acastles91/soundwalk/hw/Soundwalk/Mouser_BOM.xls

SHOPPING BASKET
This is not an invoice
14-Aug-25 05:26:35
 | Mouser No | Mfr. No | Manufacturer | Customer No | Description | RoHS | Lifecycle | Order Qty. | Price (EUR) | Ext.: (EUR)
1 | 603-RC0603FR-075K1L | RC0603FR-075K1L | YAGEO |  | Thick Film Resistors - SMD General Purpose Chip Resistor 0603, 5.1kOhms, 1%, 1/10W | RoHS Compliant By Exemption |  | 100 | 0,006 € | 0,60 €
2 | 963-EMK105B7104KV-F | EMK105B7104KV-F | TAIYO YUDEN |  | Multilayer Ceramic Capacitors MLCC - SMD/SMT 963-MSASE105SB7104KF RPLCMT PN 16V 0.1uF X7R 0402 10% | RoHS Compliant |  | 50 | 0,019 € | 0,95 €
3 | 187-CL05B104KP5VPNC | CL05B104KP5VPNC | Samsung Electro-Mechanics |  | Multilayer Ceramic Capacitors MLCC - SMD/SMT 0402 X7R 100000pF 10% 10V automotive grade | RoHS Compliant | New Product | 50 | 0,022 € | 1,10 €
4 | 279-CRGP2010F27R | CRGP2010F27R | TE Connectivity |  | Thick Film Resistors - SMD CRGP 2010 27R 1% SMD Resistor | RoHS Compliant By Exemption |  | 50 | 0,123 € | 6,15 €
5 | 708-RMCF1206FT33K2 | RMCF1206FT33K2 | SEI Stackpole |  | Thick Film Resistors - SMD 33.2KOhms 1206 0.25W 1% Std Power AEC-Q200 | RoHS Compliant By Exemption |  | 50 | 0,025 € | 1,25 €
6 | 667-ERJ-2RKF4022X | ERJ-2RKF4022X | Panasonic |  | Thick Film Resistors - SMD 0402 40.2Kohms 1% AEC-Q200 | RoHS Compliant By Exemption |  | 50 | 0,022 € | 1,10 €
7 | 660-RK73H1ETTP2103F | RK73H1ETTP2103F | KOA Speer |  | Thick Film Resistors - SMD 0.1watt 210Kohms 1% | RoHS Compliant By Exemption |  | 100 | 0,013 € | 1,30 €
8 | 80-T491C106M25AT7280 | T491C106M025AT7280 | KEMET |  | Tantalum Capacitors - Solid SMD 25V 10uF 2312 20% ESR=1.5ohms | RoHS Compliant |  | 20 | 0,401 € | 8,02 €
9 | 187-CL32B106KBJNNWE | CL32B106KBJNNWE | Samsung Electro-Mechanics |  | Multilayer Ceramic Capacitors MLCC - SMD/SMT 10uF+/-10% 50V X7R 3 1210 | RoHS Compliant |  | 50 | 0,188 € | 9,40 €
10 | 80-C0402C151K5R | C0402C151K5RACTU | KEMET |  | Multilayer Ceramic Capacitors MLCC - SMD/SMT 50V 150pF X7R 0402 10% | RoHS Compliant |  | 50 | 0,036 € | 1,80 €
11 | 708-RMCF0805FT17K4 | RMCF0805FT17K4 | SEI Stackpole |  | Thick Film Resistors - SMD 17.4KOhms 0805 0.125W 1% Std Power AEC-Q200 | RoHS Compliant By Exemption |  | 50 | 0,022 € | 1,10 €
12 | 603-RC0603JR-07200KL | RC0603JR-07200KL | YAGEO |  | Thick Film Resistors - SMD General Purpose Chip Resistor 0603, 200kOhms, 5%, 1/10W | RoHS Compliant By Exemption |  | 50 | 0,003 € | 0,15 €
13 | 581-TAJA475K016R | TAJA475K016RNJ | KYOCERA AVX |  | Tantalum Capacitors - Solid SMD 16V 4.7uF 10% 1206 E SR= 4 Ohm | RoHS Compliant |  | 20 | 0,128 € | 2,56 €
14 | 80-A768EB107M1ELAS36 | A768EB107M1ELAS036 | KEMET |  | Aluminium Organic Polymer Capacitors 25Vol 100uF SMD 2KHr ESR=36 mOhms AECQ200 | RoHS Compliant |  | 25 | 0,209 € | 5,23 €
15 | 621-B340A-F | B340A-13-F | Diodes Incorporated |  | Schottky Diodes & Rectifiers 40V 3A | RoHS Compliant By Exemption |  | 25 | 0,276 € | 6,90 €
16 | 942-IR2136SPBF | IR2136SPBF | Infineon |  | Gate Drivers 3 PHASE DRVR HI & LO SIDE INPUTS | RoHS Compliant | NRND | 3 | 5,93 € | 17,79 €
17 | 875-HZ0805E601R-10 | HZ0805E601R-10 | Laird Technologies |  | Ferrite Beads 600ohms 100MHz .5A Monolithic 0805 SMD | RoHS Compliant |  | 50 | 0,038 € | 1,90 €
18 | 604-APT3216SURCK | APT3216SURCK | Kingbright |  | Single Colour LEDs RED WATER CLEAR | RoHS Compliant |  | 20 | 0,121 € | 2,42 €
19 | 511-LM393D | LM393D | STMicroelectronics |  | Analog Comparators Lo-Pwr Dual Voltage | RoHS Compliant |  | 15 | 2,01 € | 30,15 €
20 | 863-NCP1117LPST33T3G | NCP1117LPST33T3G | onsemi |  | LDO Voltage Regulators LOW DROPOUT REGULATORS | RoHS Compliant |  | 20 | 0,219 € | 4,38 €
21 | 490-PJ-002B | PJ-002B | Same Sky |  | DC Power Connectors Power Jacks | RoHS Compliant |  | 5 | 0,413 € | 2,07 €
22 | 611-PTS526SM15SMTR2L | PTS526SM15SMTR2 LFS | C&K Switches |  | Tactile Switches 50mA 12VDC, 5.2x5.2mm, 1.5mm H, 160gf, G leads, No ground pin, metal actuator | RoHS Compliant |  | 20 | 0,108 € | 2,16 €
23 | 833-MMSS8050-H-TP | MMSS8050-H-TP | Micro Commercial Components (MCC) |  | Bipolar Transistors - BJT 625mW, 25V, 1500mA | RoHS Compliant |  | 20 | 0,071 € | 1,42 €
24 | 652-SRF3216A-222Y | SRF3216A-222Y | Bourns |  | Common Mode Chokes / Filters 2200uH 25% | RoHS Compliant |  | 10 | 0,398 € | 3,98 €
25 | 511-USBLC6-2SC6 | USBLC6-2SC6 | STMicroelectronics |  | ESD Protection Diodes / TVS Diodes ESD Protection Low Cap | RoHS Compliant |  | 20 | 0,209 € | 4,18 €
26 | 661-HHXA500A101MJA0G | HHXA500ARA101MJA0G | Chemi-Con |  | Aluminium Organic Polymer Capacitors 100uF 50V 20% Hybrid Polymer | RoHS Compliant |  | 10 | 1,56 € | 15,60 €
27 | 844-IRLZ44SPBF | IRLZ44SPBF | Vishay |  | MOSFETs TO263 N-CH 60V 50A | RoHS Compliant By Exemption |  | 20 | 1,48 € | 29,60 €
28 | 710-744771115 | 744771115 | Wurth Elektronik |  | Power Inductors - SMD WE-PD 15uH 3.75A DCR=30mOhms AEC-Q200 | RoHS Compliant |  | 10 | 1,69 € | 16,90 €
29 | 80-C0603H470J5GACTU | C0603H470J5GACTU | KEMET |  | Multilayer Ceramic Capacitors MLCC - SMD/SMT | RoHS Compliant | New At Mouser | 20 | 0,399 € | 7,98 €
30 | 637-US1J | US1J | Diotec Semiconductor |  | Rectifiers Ultrafast, SMA, 600V, 1A, 150C | RoHS Compliant By Exemption |  | 20 | 0,163 € | 3,26 €
By submitting your order you agree to these terms and conditions. (https://www.mouser.de/saleterms) |  |  |  |  |  |  |  |  | Merchandise: | 191,40 €
Prices are reflected at the date and time shown. |  |  |  |  |  |  |  |  | Delivery Charge: | 0,00 €
