acastles91/soundwalk/hw/Soundwalk/Soundwalk_BOM.xlsx

Reference | Value | Datasheet | Footprint | Qty | DNP | Digi-Key_PN | Digikey_PN | Digikey_Pn | MPN | Manufacturer_PN
R18,R19 | 0R | ~ | Resistor_SMD:R_1206_3216Metric_Pad1.30x1.75mm_HandSolder | 2 |  |  |  |  | RC0603FR-075K1L
C12,C13 | 47pF | ~ | Capacitor_SMD:C_0603_1608Metric_Pad1.08x0.95mm_HandSolder | 2 |  |  | 712-QSCP251Q470J1GV001TTR-ND |  | QSCP251Q470J1GV001T
C8,C9,C35 | 0.1uF | ~ | Capacitor_SMD:C_1206_3216Metric_Pad1.33x1.80mm_HandSolder | 3
C2 | 100n | https://search.murata.co.jp/Ceramy/image/img/A01X/G101/ENG/GRM155R71C104KA88-01.pdf | Capacitor_SMD:C_0402_1005Metric | 1 |  |  |  |  | EMK105B7104KV-F
C30 | 100nF | ~ | Capacitor_SMD:C_0402_1005Metric | 1 |  |  | 1276-CL05B104KP5VPNCTR-ND |  | CL05B104KP5VPNC
C5,C6 | 1uF | ~ | Capacitor_SMD:C_0805_2012Metric | 2
C3,C36,C37,C38 | 10uF | ~ | Capacitor_SMD:C_1210_3225Metric_Pad1.33x2.70mm_HandSolder | 4
C22,C24,C26%$%x | 10uF | ~ | Capacitor_SMD:CP_Elec_5x5.7 | 3 | DNP
L2 | 15uH | ~ | Inductor_SMD:L_TDK_SLF12565 | 1 |  |  | 445-3842-2-ND |  | SLF12565T-150M4R2-H
C4 | 22uF | ~ | Capacitor_SMD:C_1210_3225Metric_Pad1.33x2.70mm_HandSolder | 1
R12,R13 | 27R | ~ | Resistor_SMD:R_2010_5025Metric_Pad1.40x2.65mm_HandSolder | 2 |  |  |  |  | CRGP2010F27R
R54,R55,R56 | 100R | ~ | Resistor_SMD:R_1206_3216Metric_Pad1.30x1.75mm_HandSolder | 3
R10,R11 | 220R | ~ | Resistor_SMD:R_1206_3216Metric_Pad1.30x1.75mm_HandSolder | 2
R14,R15,R16,R17,R45,R51,R53,R57,R58,R66 | 1K | ~ | Resistor_SMD:R_1206_3216Metric_Pad1.30x1.75mm_HandSolder | 10 |  |  |  |  | -- mixed values --
R1,R2,R29,R39,R49 | 5.1k | ~ | Resistor_SMD:R_0603_1608Metric | 5 |  |  |  |  | RC0603FR-075K1L
R3,R4,R5,R6,R7,R8,R9,R20,R21,R22,R23,R24,R26,R27,R28,R30,R31,R32,R33,R34,R35,R36,R38,R40,R41,R42,R43,R44,R48,R50,R65 | 10K | ~ | Resistor_SMD:R_0603_1608Metric_Pad0.98x0.95mm_HandSolder | 31
R25,R37,R46 | 33K | ~ | Resistor_SMD:R_1206_3216Metric_Pad1.30x1.75mm_HandSolder | 3 |  |  | RMCF1206FT33K2TR-ND |  | RMCF1206FT33K2
R63 | 40.2k | ~ | Capacitor_SMD:C_0402_1005Metric_Pad0.74x0.62mm_HandSolder | 1 |  |  | P40.2KLTR-ND |  | ERJ-2RKF4022X
R47 | 100K | ~ | Resistor_SMD:R_1206_3216Metric_Pad1.30x1.75mm_HandSolder | 1
R64 | 210k | ~ | Capacitor_SMD:C_0402_1005Metric_Pad0.74x0.62mm_HandSolder | 1 |  |  | 2019-RK73H1ETTP2103FTR-ND |  | RK73H1ETTP2103F
R52 | 1M | ~ | Resistor_SMD:R_1206_3216Metric_Pad1.30x1.75mm_HandSolder | 1
U1 | 2137160001-Molex-USB-C-Connector | https://www.molex.com/en-us/products/part-detail-pdf/2137160001?display=pdf | privateParts:MOLEX_2137160001 | 1
C1,C11,C15,C16,C17,C19 | 0.1uF X7R 50V 0805 | ~ | Capacitor_SMD:C_0805_2012Metric_Pad1.18x1.45mm_HandSolder | 6
R60,R62 | 100K 1206 | ~ | Resistor_SMD:R_1206_3216Metric | 2
C7,C10 | 10uF 25V 2312 Tantalum | ~ | Capacitor_Tantalum_SMD:CP_EIA-6032-15_Kemet-U | 2 |  |  | 399-10160-2-ND |  | T491C106M025AT7280
C18,C23,C25,C27 | 10uF 50V X7R | ~ | -- mixed values -- | 4 |  | -- mixed values -- |  |  |  | -- mixed values --
C28 | 10uF 50V X7R 1210 | ~ | Capacitor_SMD:C_1210_3225Metric | 1 |  |  | 1276-3388-2-ND |  | CL32B106KBJNNWE
C31 | 150pF 0805 | ~ | Capacitor_SMD:C_0805_2012Metric | 1 |  |  | 399-C0402C151K5RACTUTR-ND |  | C0402C151K5RACTU
R59 | 17.4K 0805 | ~ | Resistor_SMD:R_0805_2012Metric | 1 |  |  | RMCF0805FT17K4TR-ND |  | RMCF0805FT17K4
R61 | 200K 0603 | ~ | Resistor_SMD:R_0603_1608Metric | 1 |  |  | 311-200KGRTR-ND |  | RC0603JR-07200KL
C29,C32,C33 | 22uF 6.3V | ~ | Capacitor_SMD:C_1206_3216Metric_Pad1.33x1.80mm_HandSolder | 3 |  |  | 478-12066C226MAT2A\2.5KTR-ND |  | 12066C226MAT2A\2.5K
Q3,Q4,Q5,Q6,Q7,Q8,Q9 | 2N7002E | http://www.diodes.com/assets/Datasheets/ds30376.pdf | Package_TO_SOT_SMD:SOT-23 | 7
C20 | 330uF 35V |  | Capacitor_SMD:CP_Elec_10x10.5 | 1 | DNP | 565-4786-1-ND |  |  | HHXC500ARA101MJA0G
C21 | 330uF 35V |  | Capacitor_SMD:CP_Elec_10x10.5 | 1 |  | 565-4786-1-ND |  |  | HHXC500ARA101MJA0G
C14 | 4.7uF 16V 1206 Tantalum | ~ | Capacitor_SMD:C_1206_3216Metric_Pad1.33x1.80mm_HandSolder | 1 |  |  | 478-3868-2-ND |  | TAJA475K016RNJ
C34 | C_Polarized | ~ | Capacitor_SMD:CP_Elec_6.3x5.9 | 1 |  |  | 399-A768EB107M1ELAS036TR-ND |  | A768EB107M1ELAS036
J5 | Conn_01x04_Socket | ~ | Connector_PinHeader_2.54mm:PinHeader_1x04_P2.54mm_Vertical | 1
J1 | Conn_02x06_Odd_Even | ~ | Connector_PinHeader_2.54mm:PinHeader_2x06_P2.54mm_Vertical | 1
D10 | D_Schottky | ~ | Diode_SMD:D_SMA_Handsoldering | 1 |  |  | B340A-FDITR-ND |  | B340A-13-F
U12 | DRV8833PWP | http://www.ti.com/lit/ds/symlink/drv8833.pdf | Package_SO:HTSSOP-16-1EP_4.4x5mm_P0.65mm_EP3.4x5mm_Mask2.46x2.31mm_ThermalVias | 1
U2 | ESP32-WROOM-E | https://www.espressif.com/sites/default/files/documentation/esp32-wroom-32e_esp32-wroom-32ue_datasheet_en.pdf | RF_Module:ESP32-WROOM-32E | 1
U6 | FT231XS | https://www.ftdichip.com/Support/Documents/DataSheets/ICs/DS_FT231X.pdf | Package_SO:SSOP-20_3.9x8.7mm_P0.635mm | 1 |  |  | 768-1156-5-ND |  | FT231XS-U
U9 | IR2136 |  | Package_SO:SOIC-28W_7.5x18.7mm_P1.27mm | 1 |  | IR2136SPBF-ND |  |  | IR2136SPBF
Q10,Q11,Q12,Q13,Q14,Q15,Q16 | IRLZ44N | http://www.irf.com/product-info/datasheets/data/irlz44n.pdf | Package_TO_SOT_SMD:TO-263-2 | 7 |  |  | IRLZ44NSTRLPBFTR-ND |  | IRLZ44NSTRLPBF
JP1,JP2,JP3,JP4,JP5,JP6,JP7,JP8 | Jumper_2_Open | ~ | Connector_PinHeader_2.54mm:PinHeader_1x02_P2.54mm_Vertical | 8
L1 | L_Ferrite | ~ | Inductor_SMD:L_0805_2012Metric_Pad1.05x1.20mm_HandSolder | 1 |  |  | 240-2399-2-ND |  | HZ0805E601R-10
D3,D6 | LED - Red | ~ | LED_SMD:LED_1206_3216Metric_Pad1.42x1.75mm_HandSolder | 2 |  |  | 754-1143-2-ND |  | APT3216SURCK
D2,D4,D5 | LED - Yellow | ~ | LED_SMD:LED_1206_3216Metric_Pad1.42x1.75mm_HandSolder | 3
U7,U8 | LM393 | http://www.ti.com/lit/ds/symlink/lm393.pdf | Package_SO:SOP-8_3.9x4.9mm_P1.27mm | 2 |  |  |  | 497-18379-ND | LM393D
U5 | NCP1117-3.3_SOT223 | http://www.onsemi.com/pub_link/Collateral/NCP1117-D.PDF | Package_TO_SOT_SMD:SOT-223-3_TabPin2 | 1 |  |  | NCP1117LPST33T3GOSTR-ND |  | NCP1117LPST33T3G
U10 | OKI-78SR-5_1.5-W36H-C | https://power.murata.com/data/power/oki-78sr.pdf | Converter_DCDC:Converter_DCDC_Murata_OKI-78SR_Horizontal | 1
J3 | PJ-002B |  | privateParts:CUI_PJ-002B | 1 |  |  | CP-002B-ND |  | PJ-002B
SW1,SW2 | PTS526 SM15 SMTR2 LFS | PTS526 SM15 SMTR2 LFS | SON4_PTS526 SM15 SMTR2 LFS_CNK | 2 |  |  | CKN12220-2-ND |  | PTS526SM15SMTR2 LFS
Q1,Q2 | S8050 | https://www.mccsemi.com/pdf/Products/MMSS8050(SOT-23).pdf | Package_TO_SOT_SMD:SOT-23 | 2 |  |  | MMSS8050-H-TPMSCT-ND |  | MMSS8050-H-TP
J4,J6 | Screw_Terminal_01x02 | ~ | Connector_JST:JST_XH_B2B-XH-A_1x02_P2.50mm_Vertical | 2
J2 | Screw_Terminal_01x03 | ~ | TerminalBlock_WAGO:TerminalBlock_WAGO_236-403_1x03_P5.00mm_45Degree | 1
U4 | SRF3216A-Common_Mode_Choke |  | privateParts:Bourns_SRF3216A | 1 |  | SRF3216A-222YCT-ND |  |  | SRF3216A-222Y
D1 | SS14 | https://www.vishay.com/docs/88746/ss12.pdf | Diode_SMD:D_SMA | 1
D7,D8,D9 | US1J | https://www.diodes.com/assets/Datasheets/ds16008.pdf | Diode_SMD:D_SMA | 3 |  |  | 4878-US1JTR-ND |  | US1J
U3 | %%$ | https://www.st.com/resource/en/datasheet/usblc6-2.pdf | Package_TO_SOT_SMD:SOT-23-6 | 1 |  | 497-5235-1-ND |  |  | USBLC6-2SC6
U11 | ~ |  | Package_SO:SOIC-8-1EP_3.9x4.9mm_P1.27mm_EP2.29x3mm | 1 |  |  | 1589-1587-2-ND |  | MP2467DN-LF-Z
