acastles91/soundwalk/hw/Soundwalk/Soundwalk.pdf

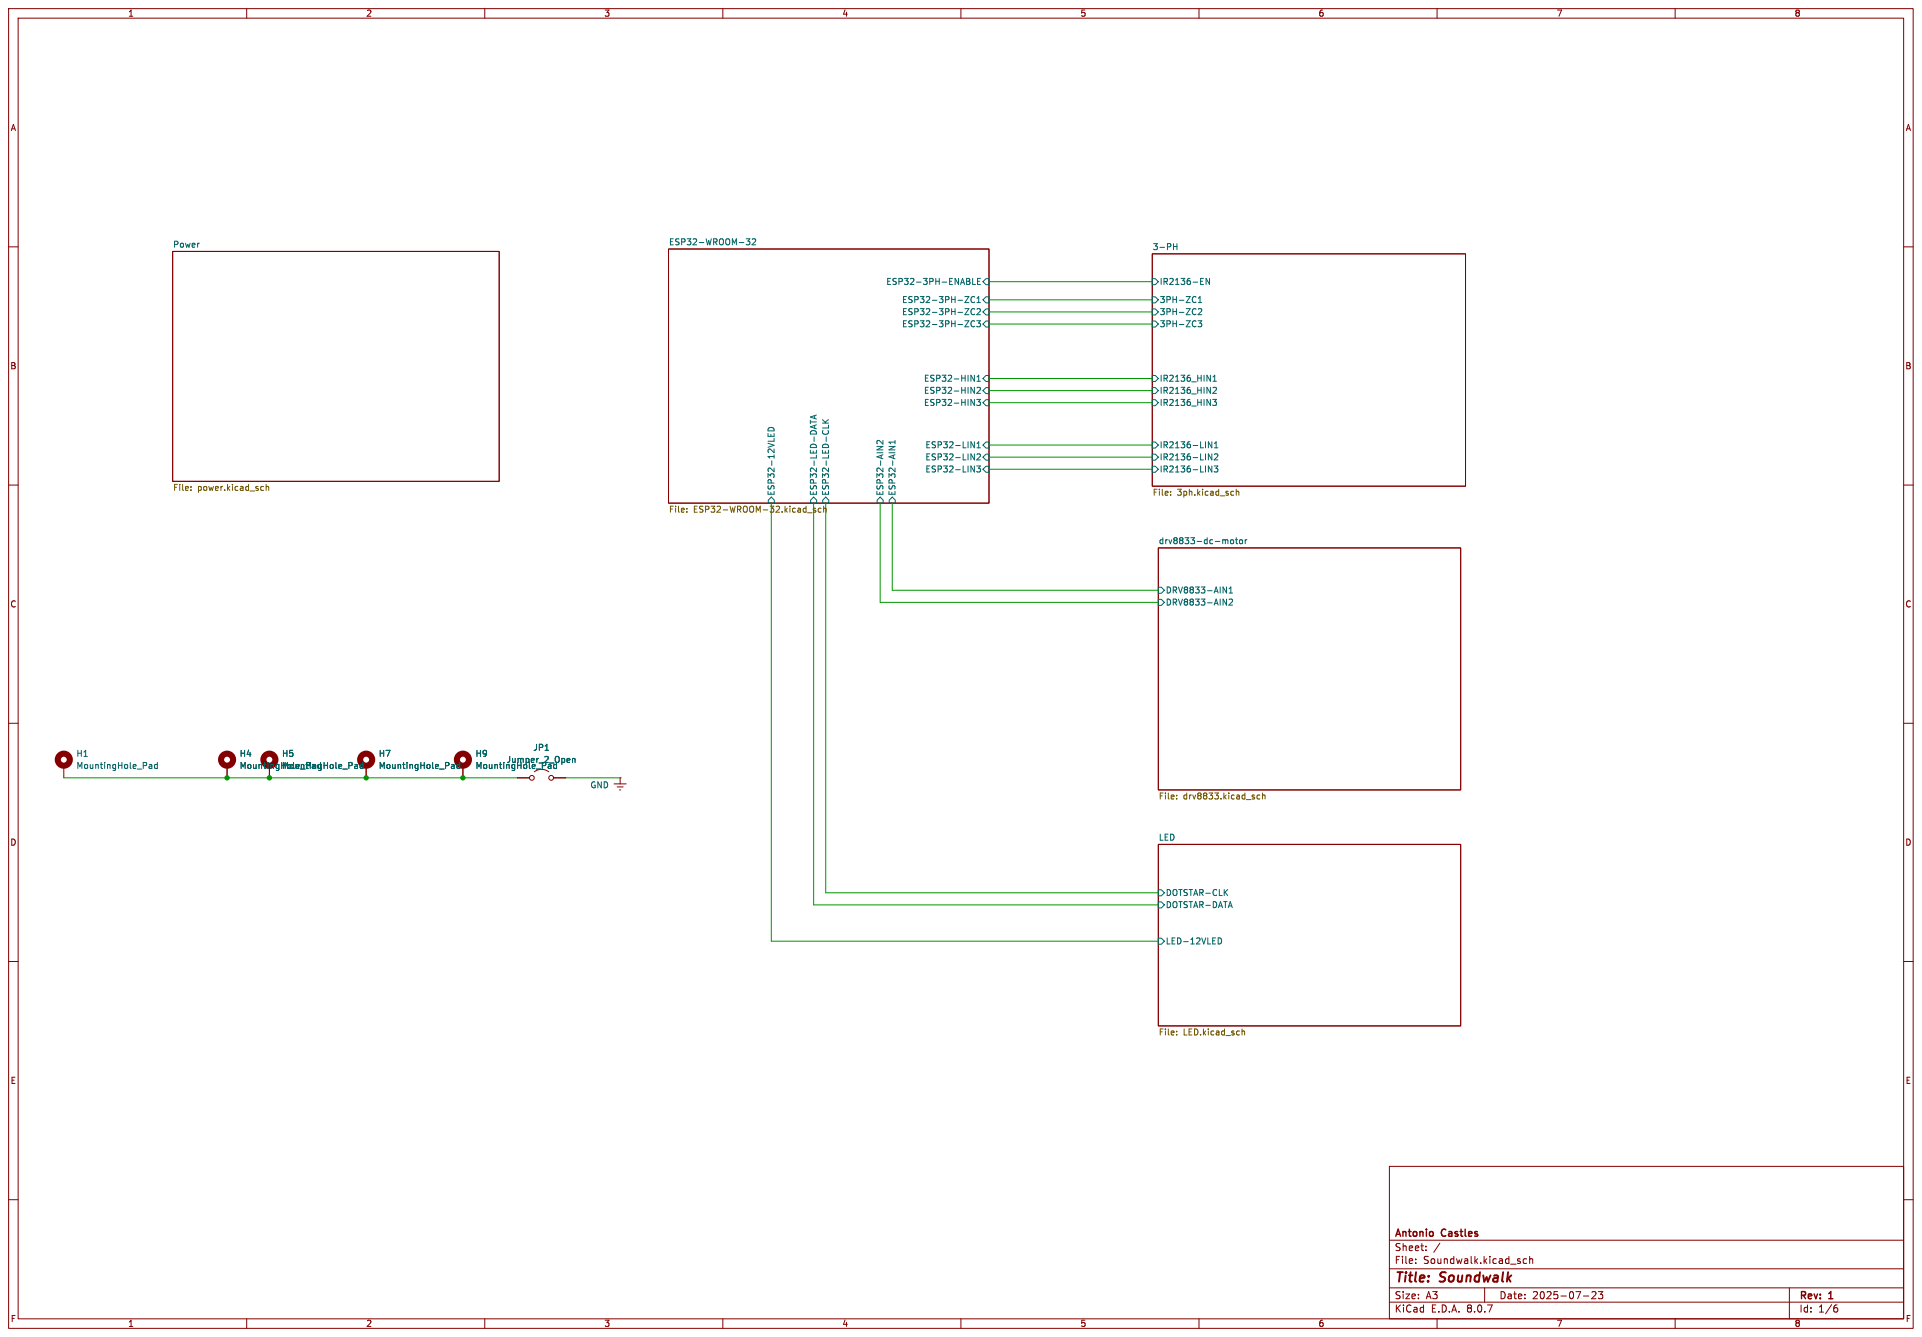
[picture p1: page 1]

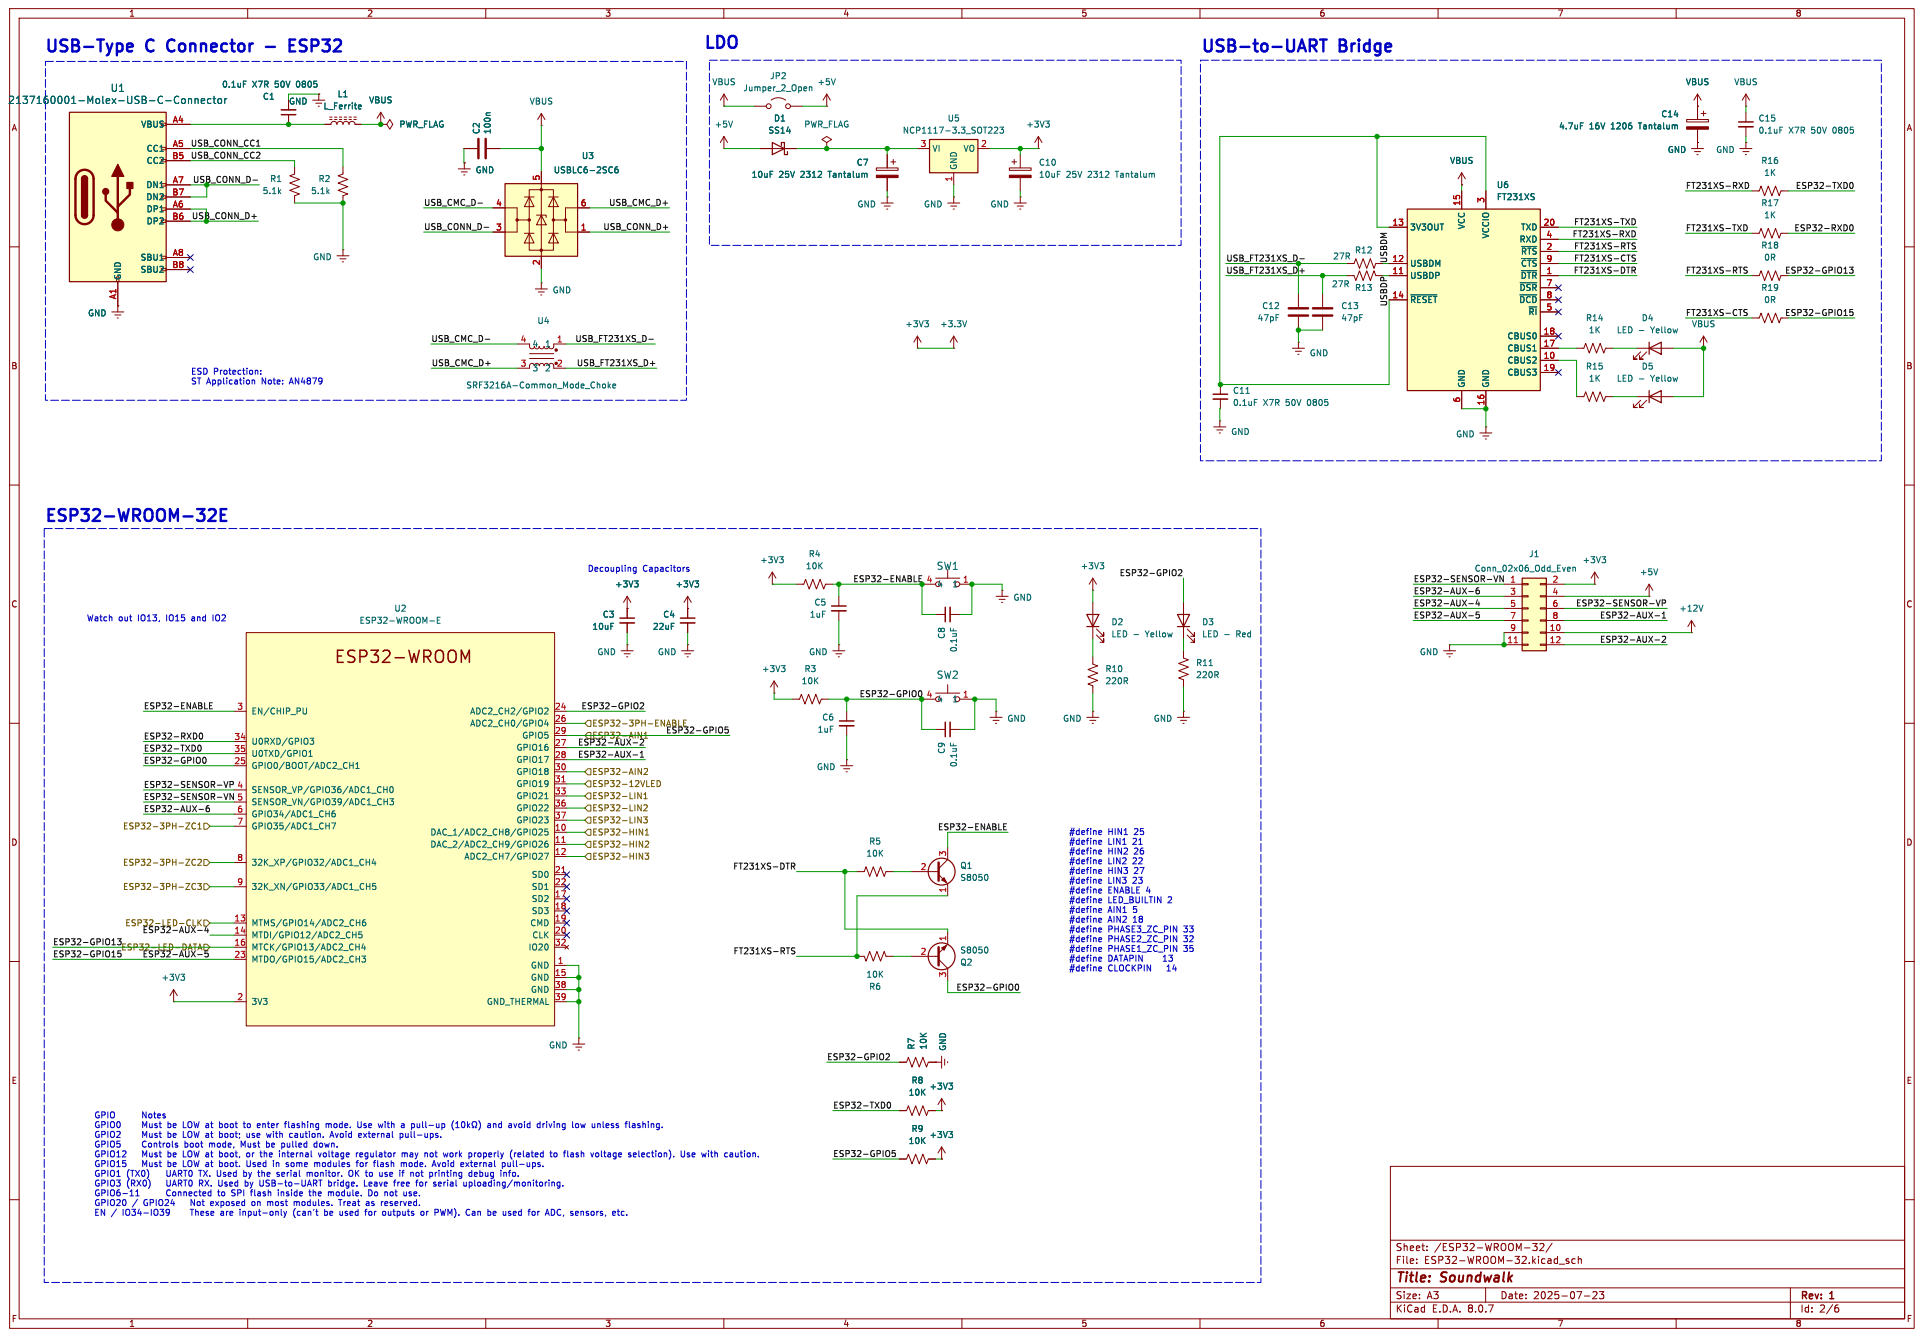
[picture p2: page 2]

1 VO 2 VI 3 U5 NCP1117-3.3_SOT223 GND GND

6 ~{DSR}7 ~{DCD}8 ~{CTS}9 U6 FT231XS GND
VBUS
ESP32-SENSOR-VN USBDM

6 ~{DSR}7 ~{DCD}8 ~{CTS}9 GND

Watch out IO13, IO15 and IO2 ESP32-WROOM-32E

File: ESP32-WROOM-32.kicad_sch Sheet: /ESP32-WROOM-32/

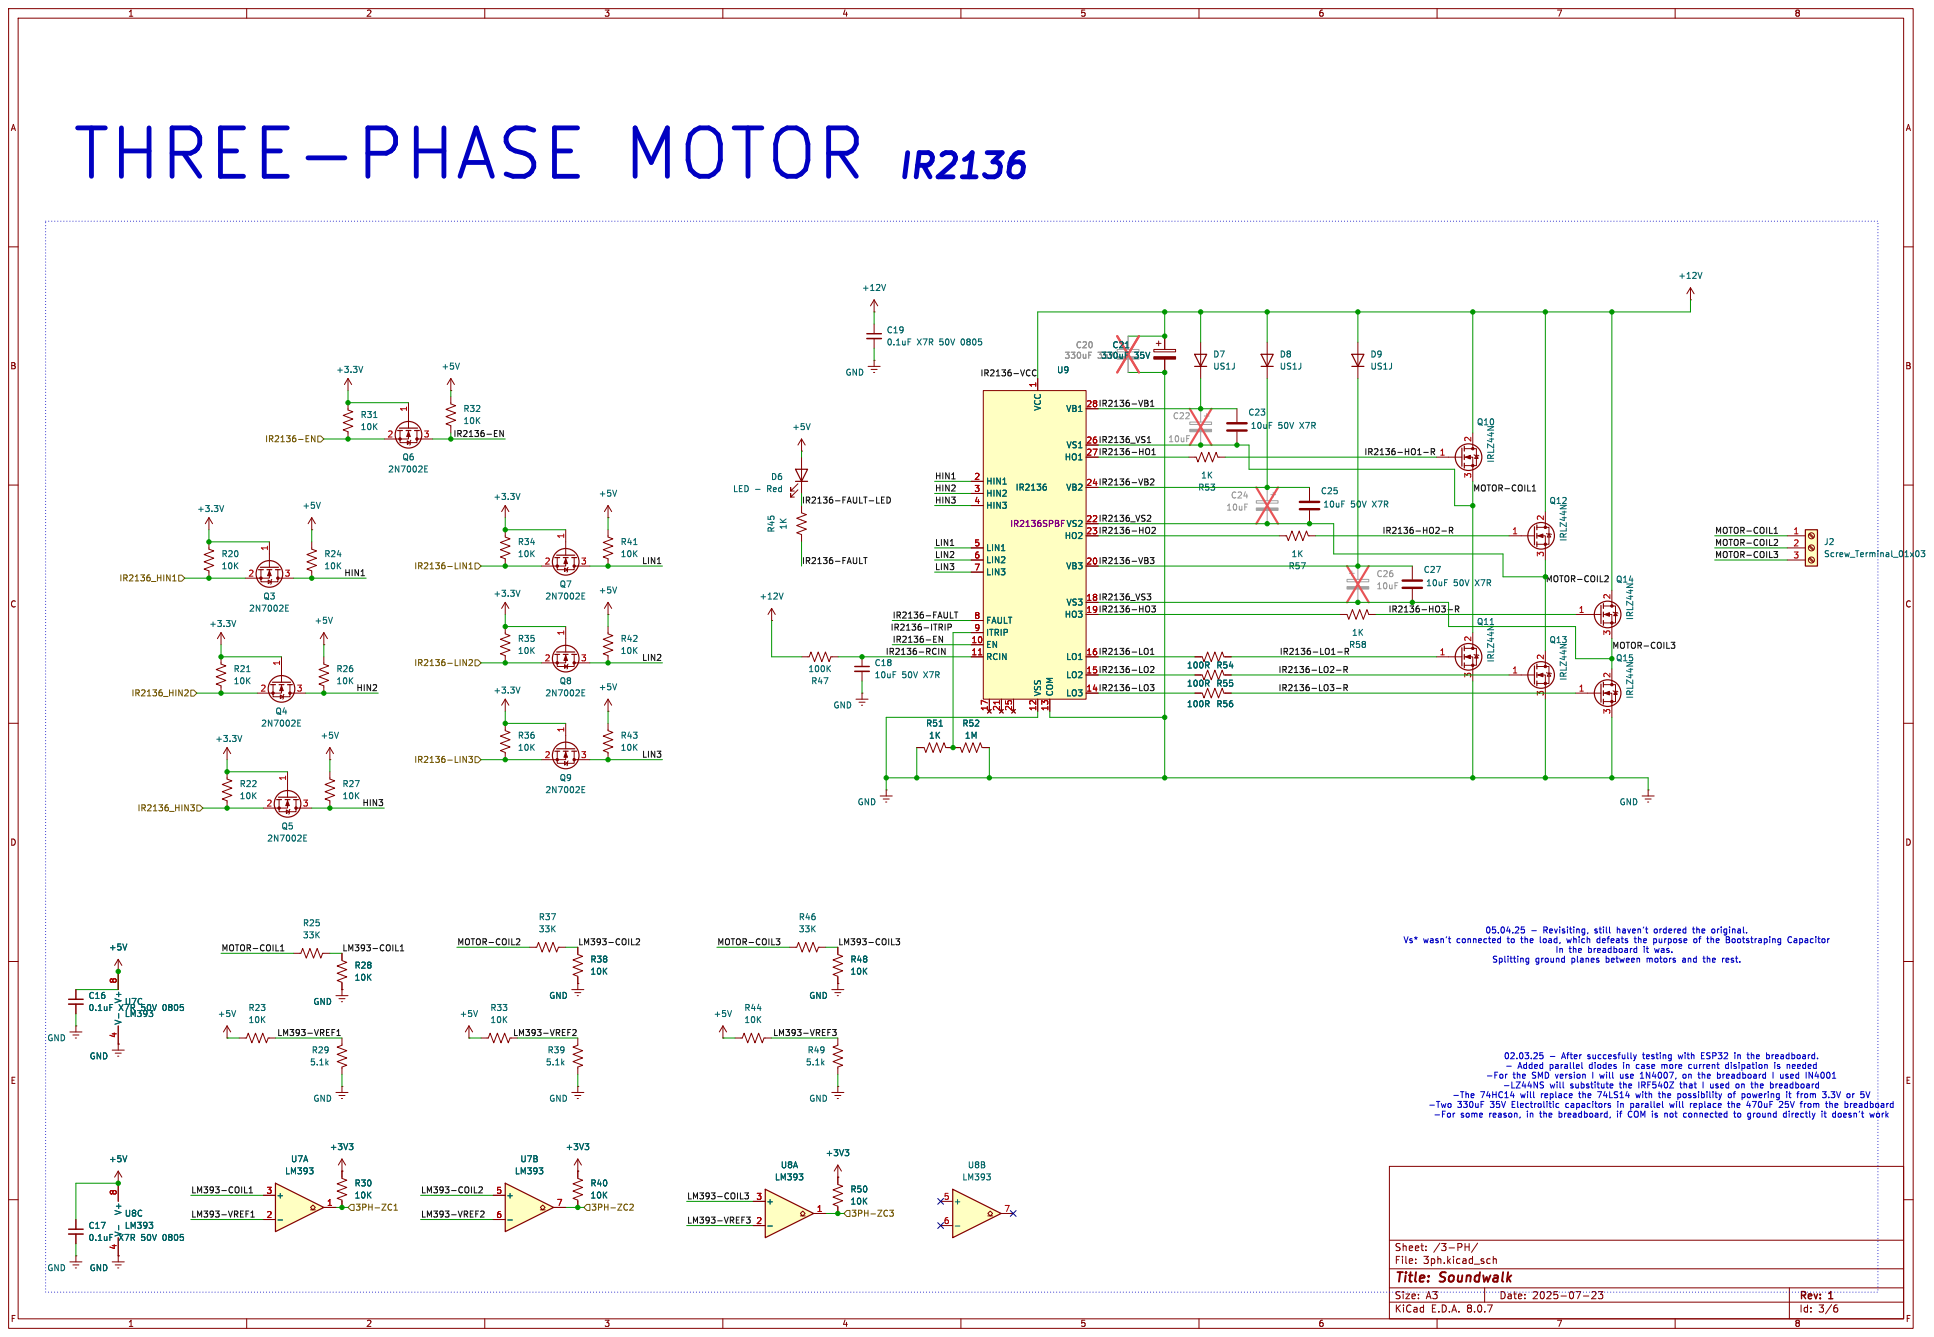
[picture p3: page 3]

1 EN 10 RCIN 11 VSS 12 COM 13

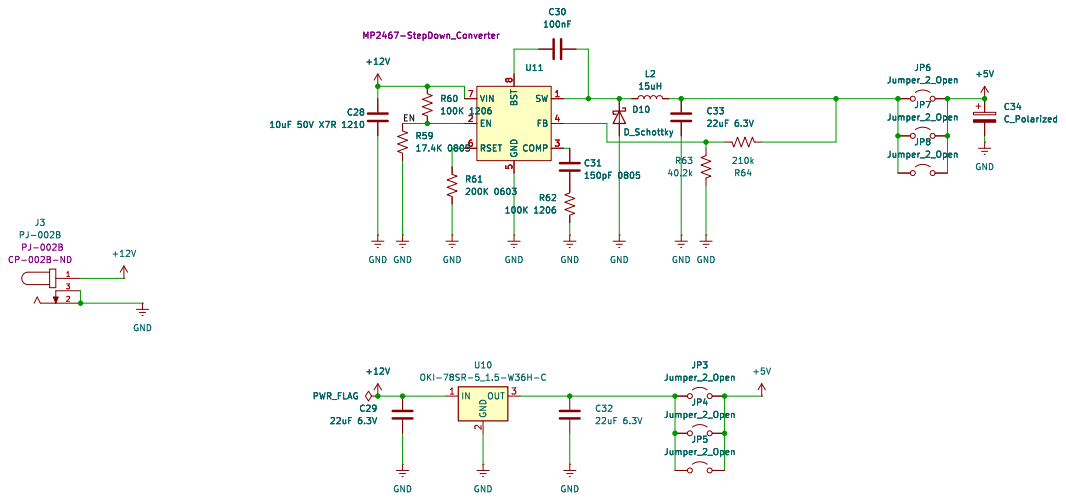
[picture p4: page 4]

2 OUT 3 U10 OKI-78SR-5_1.5-W36H-C GND GND

File: power.kicad_sch Sheet: /Power/

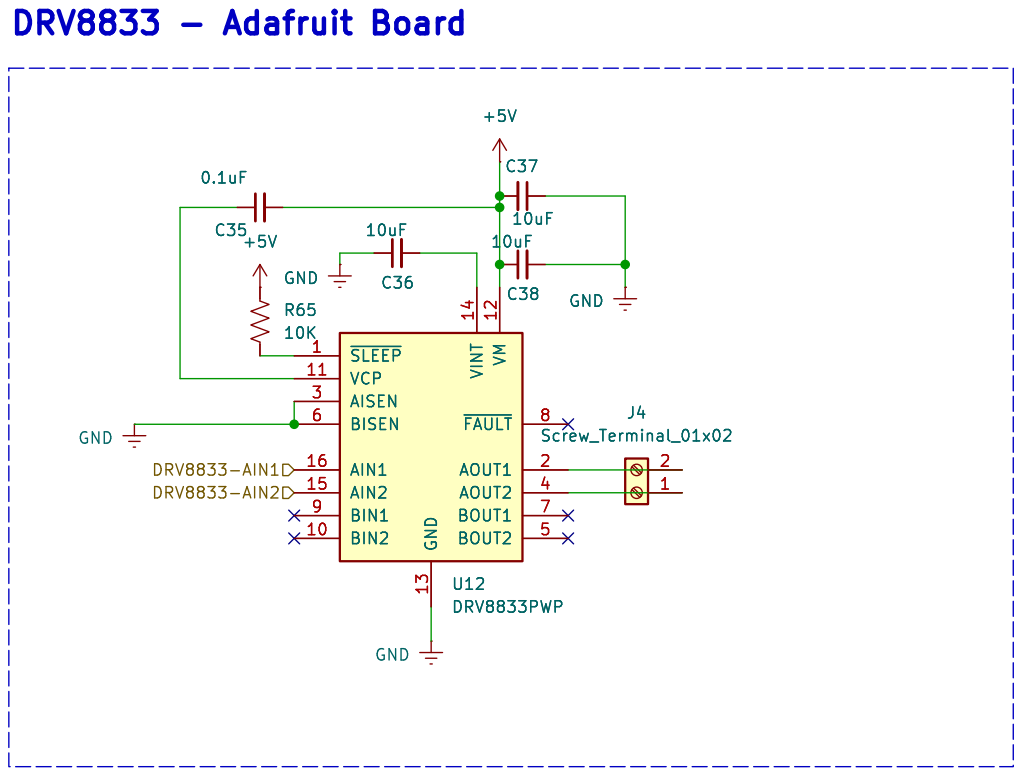
[picture p5: page 5]

File: drv8833.kicad_sch Sheet: /drv8833-dc-motor/

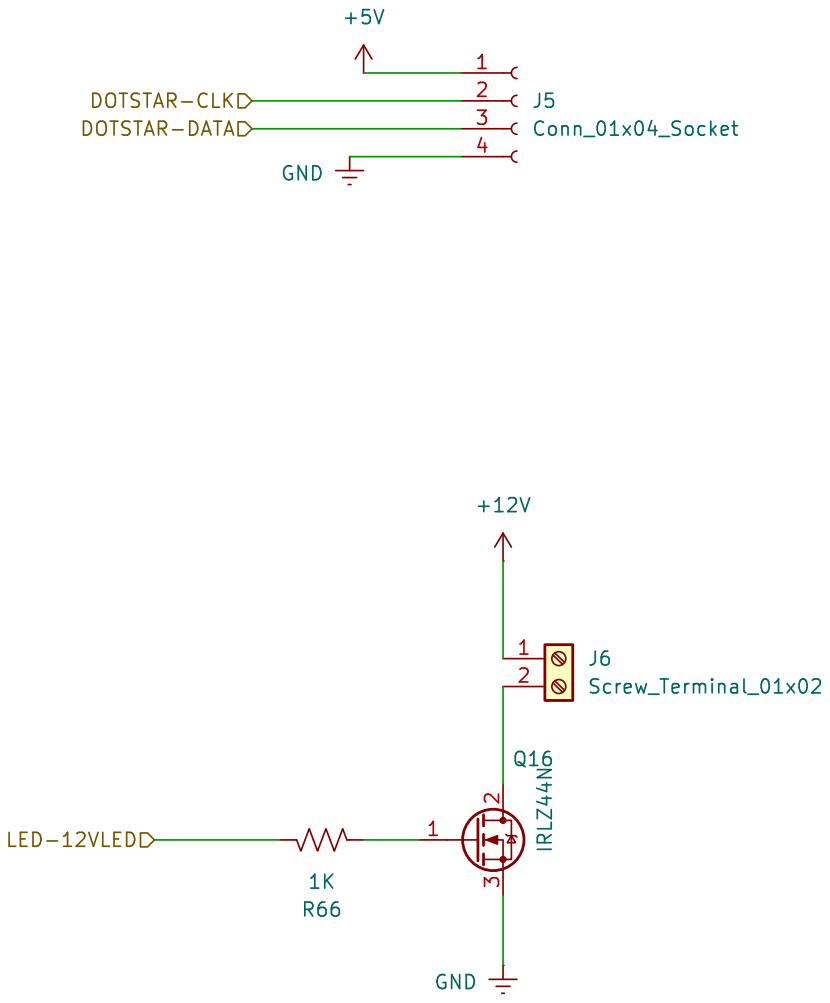
[picture p6: page 6]

J6Screw_Terminal_01x02 +12V DOTSTAR-DATA DOTSTAR-CLK

File: LED.kicad_sch Sheet: /LED/
