acastles91/soundwalk/hw/Soundwalk/Soundwalk.kicad_pcb

## KiCad design hw/Soundwalk/Soundwalk.kicad_pcb (2025-08-17)

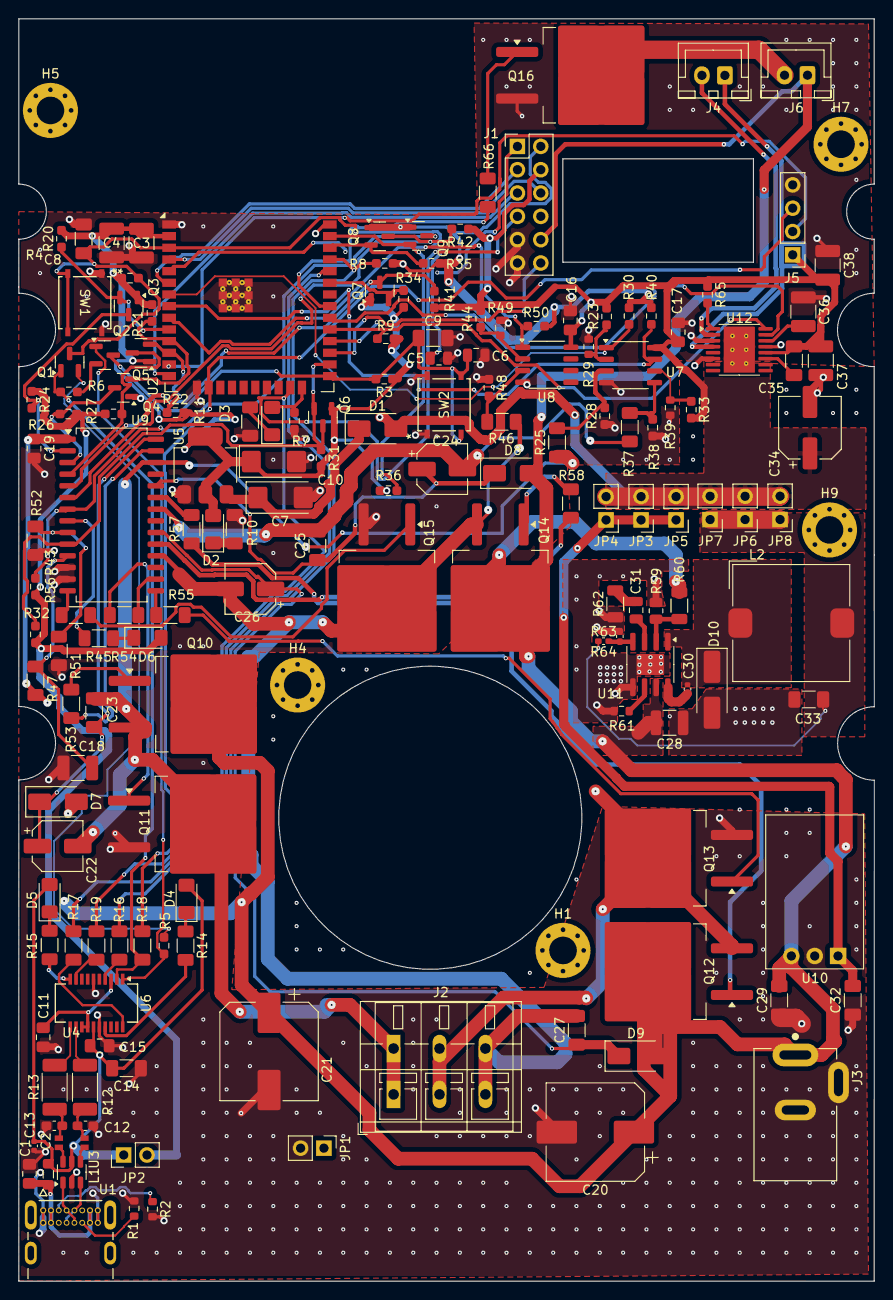
[picture p7: board Soundwalk.kicad_pcb from above]

Board: 4 copper layers, 93.1 x 137.5 mm, 165 parts (0 on the bottom side), 109 nets.

Parts:
C1, C11, C15, C16, C17, C19: 0.1uF X7R 50V 0805; C_0805_2012Metric_Pad1.18x1.45mm_HandSolder
C2: 100n; C_0402_1005Metric
C3, C36, C37, C38: 10uF; C_1210_3225Metric_Pad1.33x2.70mm_HandSolder
C4: 22uF; C_1210_3225Metric_Pad1.33x2.70mm_HandSolder
C5, C6: 1uF; C_0805_2012Metric
C7, C10: 10uF 25V 2312 Tantalum; CP_EIA-6032-15_Kemet-U
C8, C9, C35: 0.1uF; C_1206_3216Metric_Pad1.33x1.80mm_HandSolder
C12, C13: 47pF; C_0603_1608Metric_Pad1.08x0.95mm_HandSolder
C14: 4.7uF 16V 1206 Tantalum; C_1206_3216Metric_Pad1.33x1.80mm_HandSolder
C18: 10uF 50V X7R; C_1210_3225Metric_Pad1.33x2.70mm_HandSolder
C20, C21: 330uF 35V; CP_Elec_10x10.5
C22, C24, C26: 10uF; CP_Elec_5x5.7
C23, C25, C27: 10uF 50V X7R; C_1206_3216Metric_Pad1.33x1.80mm_HandSolder
C28: 10uF 50V X7R 1210; C_1210_3225Metric
C29, C32, C33: 22uF 6.3V; C_1206_3216Metric_Pad1.33x1.80mm_HandSolder
C30: 100nF; C_0402_1005Metric
C31: 150pF 0805; C_0805_2012Metric
C34: C_Polarized; CP_Elec_6.3x5.9
D1: SS14; D_SMA
D2, D4, D5: LED - Yellow; LED_1206_3216Metric_Pad1.42x1.75mm_HandSolder
D3, D6: LED - Red; LED_1206_3216Metric_Pad1.42x1.75mm_HandSolder
D7, D8, D9: US1J; D_SMA
D10: D_Schottky; D_SMA_Handsoldering
H1, H4, H5, H7, H9: MountingHole_Pad; MountingHole_3mm_Pad_Via
J1: Conn_02x06_Odd_Even; PinHeader_2x06_P2.54mm_Vertical
J2: Screw_Terminal_01x03; TerminalBlock_WAGO_236-403_1x03_P5.00mm_45Degree
J3: PJ-002B; CUI_PJ-002B
J4, J6: Screw_Terminal_01x02; JST_XH_B2B-XH-A_1x02_P2.50mm_Vertical
J5: Conn_01x04_Socket; PinHeader_1x04_P2.54mm_Vertical
JP1, JP2, JP3, JP4, JP5, JP6, JP7, JP8: Jumper_2_Open; PinHeader_1x02_P2.54mm_Vertical
L1: L_Ferrite; L_0805_2012Metric_Pad1.05x1.20mm_HandSolder
L2: 15uH; L_TDK_SLF12565
Q1, Q2: S8050; SOT-23
Q3, Q4, Q5, Q6, Q7, Q8, Q9: 2N7002E; SOT-23
Q10, Q11, Q12, Q13, Q14, Q15, Q16: IRLZ44N; TO-263-2
R1, R2, R29, R39, R49: 5.1k; R_0603_1608Metric
R3, R4, R5, R6, R7, R8, R9, R20, R21, R22, R23, R24, R26, R27, R28, R30, R31, R32, R33, R34, R35, R36, R38, R40, R41, R42, R43, R44, R48, R50, R65: 10K; R_0603_1608Metric_Pad0.98x0.95mm_HandSolder
R10, R11: 220R; R_1206_3216Metric_Pad1.30x1.75mm_HandSolder
R12, R13: 27R; R_2010_5025Metric_Pad1.40x2.65mm_HandSolder
R14, R15, R16, R17, R45, R51, R53, R57, R58, R66: 1K; R_1206_3216Metric_Pad1.30x1.75mm_HandSolder
R18, R19: 0R; R_1206_3216Metric_Pad1.30x1.75mm_HandSolder
R25, R37, R46: 33K; R_1206_3216Metric_Pad1.30x1.75mm_HandSolder
R47: 100K; R_1206_3216Metric_Pad1.30x1.75mm_HandSolder
R52: 1M; R_1206_3216Metric_Pad1.30x1.75mm_HandSolder
R54, R55, R56: 100R; R_1206_3216Metric_Pad1.30x1.75mm_HandSolder
R59: 17.4K 0805; R_0805_2012Metric
R60, R62: 100K 1206; R_1206_3216Metric
R61: 200K 0603; R_0603_1608Metric
R63: 40.2k; C_0402_1005Metric_Pad0.74x0.62mm_HandSolder
R64: 210k; C_0402_1005Metric_Pad0.74x0.62mm_HandSolder
SW1, SW2: PTS526 SM15 SMTR2 LFS; SON4_PTS526 SM15 SMTR2 LFS_CNK
U1: 2137160001-Molex-USB-C-Connector; MOLEX_2137160001
U2: ESP32-WROOM-E; ESP32-WROOM-32E
U3: USBLC6-2SC6; SOT-23-6
U4: SRF3216A-Common_Mode_Choke; Bourns_SRF3216A
U5: NCP1117-3.3_SOT223; SOT-223-3_TabPin2
U6: FT231XS; SSOP-20_3.9x8.7mm_P0.635mm
U7, U8: LM393; SOP-8_3.9x4.9mm_P1.27mm
U9: IR2136; SOIC-28W_7.5x18.7mm_P1.27mm
U10: OKI-78SR-5_1.5-W36H-C; Converter_DCDC_Murata_OKI-78SR_Horizontal
U11: SOIC-8-1EP_3.9x4.9mm_P1.27mm_EP2.29x3mm
U12: DRV8833PWP; HTSSOP-16-1EP_4.4x5mm_P0.65mm_EP3.4x5mm_Mask2.46x2.31mm_The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

Connections:
+3.3V: C3.1, C4.1, C10.1, D2.2 (A), J1.2, Q3.1 (G), Q4.1 (G), Q5.1 (G), Q6.1 (G), Q7.1 (G), Q8.1 (G), Q9.1 (G), R3.1, R4.1, R8.2, R9.2, R20.2, R21.2, R22.2, R30.1, R31.2, R34.2, R35.2, R36.2, R40.1, R50.1, U2.2 (3V3), U5.2 (VO)
+5V: C16.1, C17.1, C34.1, C35.2, C37.2, C38.1, D1.2 (A), D6.2 (A), J1.4, J5.1, JP2.2 (B), JP3.2 (B), JP4.2 (B), JP5.2 (B), JP6.2 (B), JP7.2 (B), JP8.2 (B), R23.2, R24.1, R26.1, R27.1, R32.1, R33.2, R41.1, R42.1, R43.1, R44.2, R65.1, U7.8 (V+), U8.8 (V+), U12.12 (VM)
+12V: C19.1, C20.1, C21.1, C28.2, C29.2, D7.2 (A), D8.2 (A), D9.2 (A), J1.10, J3.1, J6.1, Q10.2 (D), Q12.2 (D), Q14.2 (D), R47.2, R60.2, U9.1 (VCC), U10.1 (IN), U11.7 (VIN)
/3-PH/3PH-ZC1: R30.2, U2.7 (GPIO35/ADC1_CH7), U7.1
/3-PH/3PH-ZC2: R40.2, U2.8 (32K_XP/GPIO32/ADC1_CH4), U7.7
/3-PH/3PH-ZC3: R50.2, U2.9 (32K_XN/GPIO33/ADC1_CH5), U8.1
/3-PH/HIN1: Q3.3 (D), R24.2, U9.2 (HIN1)
/3-PH/HIN2: Q4.3 (D), R26.2, U9.3 (HIN2)
/3-PH/HIN3: Q5.3 (D), R27.2, U9.4 (HIN3)
/3-PH/IR2136-EN: Q6.2 (S), Q6.3 (D), R31.1, R32.2, U2.26 (ADC2_CH0/GPIO4), U9.10 (EN)
/3-PH/IR2136-FAULT: R45.2, U9.8 (FAULT)
/3-PH/IR2136-FAULT-LED: D6.1 (K), R45.1
/3-PH/IR2136-HO1: R53.2, U9.27 (HO1)
/3-PH/IR2136-HO1-R: Q10.1 (G), R53.1
/3-PH/IR2136-HO2: R57.2, U9.23 (HO2)
/3-PH/IR2136-HO2-R: Q12.1 (G), R57.1
/3-PH/IR2136-HO3: R58.2, U9.19 (HO3)
/3-PH/IR2136-HO3-R: Q14.1 (G), R58.1
/3-PH/IR2136-ITRIP: R51.1, R52.2, U9.9 (ITRIP)
/3-PH/IR2136-LIN1: Q7.2 (S), R34.1, U2.33 (GPIO21)
/3-PH/IR2136-LIN2: Q8.2 (S), R35.1, U2.36 (GPIO22)
/3-PH/IR2136-LIN3: Q9.2 (S), R36.1, U2.37 (GPIO23)
/3-PH/IR2136-LO1: R54.2, U9.16 (LO1)
/3-PH/IR2136-LO1-R: Q11.1 (G), R54.1
/3-PH/IR2136-LO2: R55.2, U9.15 (LO2)
/3-PH/IR2136-LO2-R: Q13.1 (G), R55.1
/3-PH/IR2136-LO3: R56.2, U9.14 (LO3)
/3-PH/IR2136-LO3-R: Q15.1 (G), R56.1
/3-PH/IR2136-RCIN: C18.1, R47.1, U9.11 (RCIN)
/3-PH/IR2136-VB1: C22.1, C23.1, D7.1 (K), U9.28 (VB1)
/3-PH/IR2136-VB2: C24.1, C25.1, D8.1 (K), U9.24 (VB2)
/3-PH/IR2136-VB3: C26.1, C27.1, D9.1 (K), U9.20 (VB3)
/3-PH/IR2136_HIN1: Q3.2 (S), R20.1, U2.10 (DAC_1/ADC2_CH8/GPIO25)
/3-PH/IR2136_HIN2: Q4.2 (S), R21.1, U2.11 (DAC_2/ADC2_CH9/GPIO26)
/3-PH/IR2136_HIN3: Q5.2 (S), R22.1, U2.12 (ADC2_CH7/GPIO27)
/3-PH/IR2136_VS1: C22.2, C23.2, J2.1, Q10.3 (S), Q11.2 (D), R25.1, U9.26 (VS1)
/3-PH/IR2136_VS2: C24.2, C25.2, J2.2, Q12.3 (S), Q13.2 (D), R37.1, U9.22 (VS2)
/3-PH/IR2136_VS3: C26.2, C27.2, J2.3, Q14.3 (S), Q15.2 (D), R46.1, U9.18 (VS3)
/3-PH/LIN1: Q7.3 (D), R41.2, U9.5 (LIN1)
/3-PH/LIN2: Q8.3 (D), R42.2, U9.6 (LIN2)
/3-PH/LIN3: Q9.3 (D), R43.2, U9.7 (LIN3)
/3-PH/LM393-COIL1: R25.2, R28.2, U7.3 (+)
/3-PH/LM393-COIL2: R37.2, R38.2, U7.5 (+)
/3-PH/LM393-COIL3: R46.2, R48.2, U8.3 (+)
/3-PH/LM393-VREF1: R23.1, R29.1, U7.2 (-)
/3-PH/LM393-VREF2: R33.1, R39.1, U7.6 (-)
/3-PH/LM393-VREF3: R44.1, R49.1, U8.2 (-)
/ESP32-WROOM-32/ESP32-12VLED: R66.2, U2.31 (GPIO19)
/ESP32-WROOM-32/ESP32-AIN2: U2.30 (GPIO18), U12.15 (AIN2)
/ESP32-WROOM-32/ESP32-AUX-1: J1.8, U2.28 (GPIO17)
/ESP32-WROOM-32/ESP32-AUX-2: J1.12, U2.27 (GPIO16)
/ESP32-WROOM-32/ESP32-AUX-4: J1.5, U2.14 (MTDI/GPIO12/ADC2_CH5)
/ESP32-WROOM-32/ESP32-AUX-5: J1.7, R19.1, U2.23 (MTDO/GPIO15/ADC2_CH3)
/ESP32-WROOM-32/ESP32-AUX-6: J1.3, U2.6 (GPIO34/ADC1_CH6)
/ESP32-WROOM-32/ESP32-ENABLE: C5.1, C8.1, Q1.3 (C), R4.2, SW1.3, SW1.4, U2.3 (EN/CHIP_PU)
/ESP32-WROOM-32/ESP32-GPIO0: C6.1, C9.1, Q2.3 (C), R3.2, SW2.3, SW2.4, U2.25 (GPIO0/BOOT/ADC2_CH1)
/ESP32-WROOM-32/ESP32-GPIO2: D3.2 (A), R7.2, U2.24 (ADC2_CH2/GPIO2)
/ESP32-WROOM-32/ESP32-GPIO5: R9.1, U2.29 (GPIO5), U12.16 (AIN1)
/ESP32-WROOM-32/ESP32-GPIO13: J5.3, R18.1, U2.16 (MTCK/GPIO13/ADC2_CH4)
/ESP32-WROOM-32/ESP32-LED-CLK: J5.2, U2.13 (MTMS/GPIO14/ADC2_CH6)
/ESP32-WROOM-32/ESP32-RXD0: R17.1, U2.34 (U0RXD/GPIO3)
/ESP32-WROOM-32/ESP32-SENSOR-VN: J1.1, U2.5 (SENSOR_VN/GPIO39/ADC1_CH3)
/ESP32-WROOM-32/ESP32-SENSOR-VP: J1.6, U2.4 (SENSOR_VP/GPIO36/ADC1_CH0)
/ESP32-WROOM-32/ESP32-TXD0: R8.1, R16.1, U2.35 (U0TXD/GPIO1)
/ESP32-WROOM-32/FT231XS-CTS: R19.2, U6.9 (~CTS)
/ESP32-WROOM-32/FT231XS-DTR: Q2.1 (E), R5.1, U6.1 (~DTR)
/ESP32-WROOM-32/FT231XS-RTS: Q1.1 (E), R6.1, R18.2, U6.2 (~RTS)
/ESP32-WROOM-32/FT231XS-RXD: R16.2, U6.4 (RXD)
/ESP32-WROOM-32/FT231XS-TXD: R17.2, U6.20 (TXD)
/ESP32-WROOM-32/USBDM: R12.2, U6.12 (USBDM)
/ESP32-WROOM-32/USBDP: R13.2, U6.11 (USBDP)
/ESP32-WROOM-32/USB_CMC_D+: U3.6 (I/O1), U4.3
/ESP32-WROOM-32/USB_CMC_D-: U3.4 (I/O2), U4.4
/ESP32-WROOM-32/USB_CONN_CC1: R2.1, U1.A5 (CC1)
/ESP32-WROOM-32/USB_CONN_CC2: R1.1, U1.B5 (CC2)
/ESP32-WROOM-32/USB_CONN_D+: U1.A6 (DP1), U1.B6 (DP2), U3.1 (I/O1)
/ESP32-WROOM-32/USB_CONN_D-: U1.A7 (DN1), U1.B7 (DN2), U3.3 (I/O2)
/ESP32-WROOM-32/USB_FT231XS_D+: C13.1, R13.1, U4.2
/ESP32-WROOM-32/USB_FT231XS_D-: C12.1, R12.1, U4.1
/Power/EN: R59.2, R60.1, U11.2 (EN)
GND: C1.2, C2.1, C3.2, C4.2, C5.2, C6.2, C7.2, C8.2, C9.2, C10.2, C11.2, C12.2, C13.2, C14.2, C15.2, C16.2, C17.2, C18.2, C19.2, C20.2, C21.2, C28.1, C29.1, C32.1, C33.1, C34.2, C36.1, C37.1, C38.2, D10.2 (A), J1.9, J1.11, J3.2, J3.3, J5.4, JP1.2 (B), Q11.3 (S), Q13.3 (S), Q15.3 (S), Q16.3 (S), R1.2, R2.2, R7.1, R10.1, R11.1, R28.1, R29.2, R38.1, R39.2, R48.1, R49.2, R51.2, R52.1, R59.1, R61.1, R62.1, R63.1, SW1.1, SW1.2, SW2.1, SW2.2, U1.A1 (GND), U1.A12 (GND), U1.B1 (GND), U1.B12 (GND), U2.1 (GND), U2.15 (GND), U2.38 (GND), U2.39 (GND_THERMAL), U3.2 (GND), U5.1 (GND), U6.6 (GND), U6.16 (GND), U7.4 (V-), U8.4 (V-), U9.12 (VSS), U9.13 (COM), U10.2 (GND), U11.5 (GND), U11.9 (PAD), U12.3 (AISEN), U12.6 (BISEN), U12.13 (GND), U12.17 (GND)
unnamed: C31.1, R62.2
unnamed: C7.1, D1.1 (K), U5.3 (VI)
unnamed: D2.1 (K), R10.2
unnamed: D3.1 (K), R11.2
unnamed: D4.1 (K), R14.1
unnamed: D5.1 (K), R15.1
unnamed: C30.2, D10.1 (K), L2.1, U11.1 (SW)
unnamed: J4.1, U12.4 (AOUT2)
unnamed: J4.2, U12.2 (AOUT1)
unnamed: J6.2, Q16.2 (D)
unnamed: H1.1, H4.1, H5.1, H7.1, H9.1, JP1.1 (A)
unnamed: C32.2, JP3.1 (A), JP4.1 (A), JP5.1 (A), U10.3 (OUT)
unnamed: C33.2, JP6.1 (A), JP7.1 (A), JP8.1 (A), L2.2, R64.2
unnamed: Q1.2 (B), R5.2
unnamed: Q2.2 (B), R6.2
unnamed: Q16.1 (G), R66.1
unnamed: C11.1, U6.3 (VCCIO), U6.13 (3V3OUT), U6.14 (~RESET)
unnamed: R14.2, U6.17 (CBUS1)
unnamed: R15.2, U6.10 (CBUS2)
unnamed: C30.1, U11.8 (BST)
unnamed: C31.2, U11.3 (COMP)
unnamed: R63.2, R64.1, U11.4 (FB)
unnamed: R61.2, U11.6 (RSET)
unnamed: C35.1, U12.11 (VCP)
unnamed: C36.2, U12.14 (VINT)
unnamed: R65.2, U12.1 (~SLEEP)
V-BUS: C1.1, L1.1, U1.A4 (V-BUS), U1.A9 (V-BUS), U1.B4 (V-BUS), U1.B9 (V-BUS)
VBUS: C2.2, C14.1, C15.1, D4.2 (A), D5.2 (A), JP2.1 (A), L1.2, U3.5 (VBUS), U6.15 (VCC)
