acastles91/soundwalk/(commit log)

2025-08-02 working, problems with back emf
    [3ph.kicad_sch, ESP32-WROOM-32.kicad_sch, LED.kicad_sch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]
2025-08-10 basic operation with 2 slaves
    [2025-08-06T093904.csv, Soundwalk.csv, Soundwalk_BOM.csv, Soundwalk_BOM.ods]
2025-08-17 it's getting there
    [DK_BOM.csv, Mouser_BOM.xls, Soundwalk_BOM.xlsx]
2025-08-19 at the recording studio
    [Soundwalk.kicad_pcb]
